BoraRider/Latarka-100W/README.md

# Latarka-100W
Projekt latarki zdalnie sterowanej o mocy 100w.
Projekt powstał na zaliczenie kursu Podstawy Techniki Mikroproceosrowej 2 na Politechnice Wrocłwaskiej
